lucabelluccini/accelerometermouse/README.md

# accelerometermouse
Automatically exported from code.google.com/p/accelerometermouse

Accelerometer-based USB Mouse, powered by
  * Microchip PIC18F14K50 microcontroller
  * MEMSIC MXC62020J accelerometer

[Video](http://www.youtube.com/watch?v=kykNB3RcyWo)
