lucabelluccini/accelerometermouse/Files/electrical-diagram.png

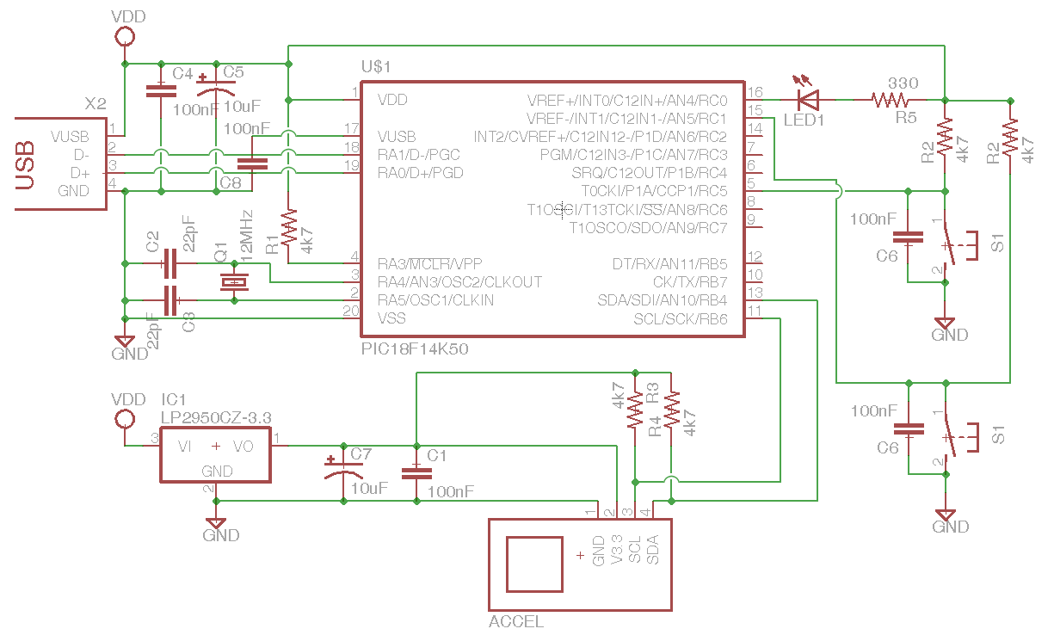
Files/electrical-diagram.png
