lucabelluccini/accelerometermouse/Files/assembly-diagram-lacks of a switch.pdf

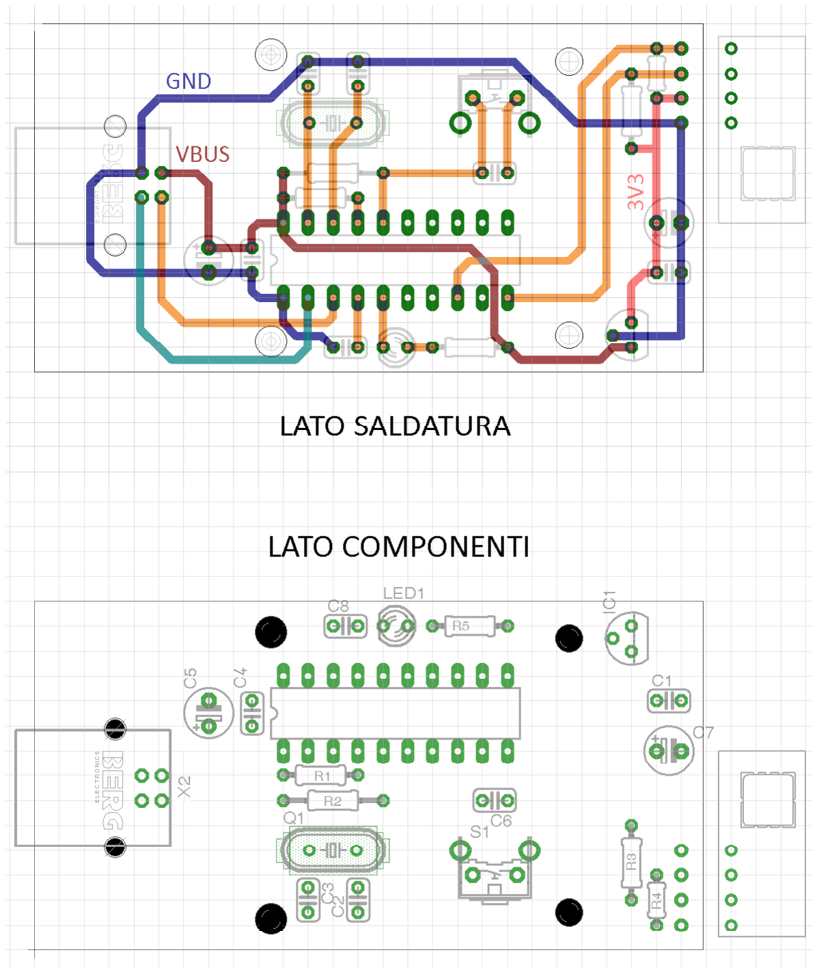
[picture p2: page 1]
