lucabelluccini/accelerometermouse/TopoTester/Resources/231_topo_trappola_1.jpg

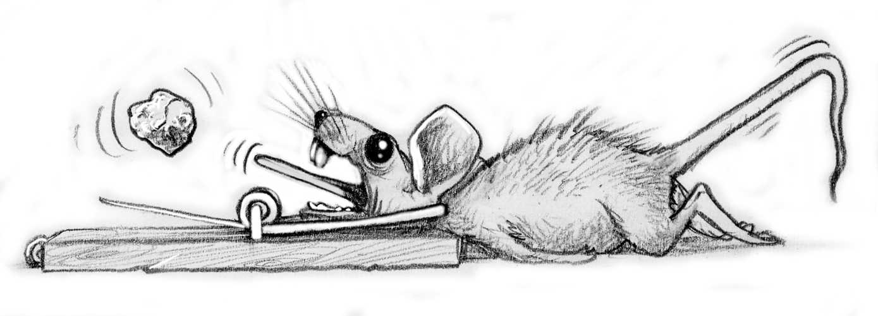
TopoTester/Resources/231_topo_trappola_1.jpg
