lucabelluccini/accelerometermouse/TopoTester/Resources/direzioni.png

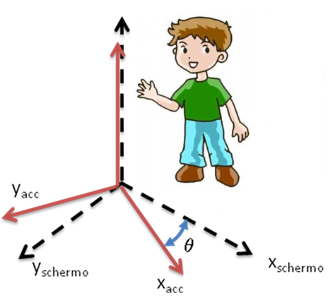
TopoTester/Resources/direzioni.png
