lucabelluccini/accelerometermouse/TopoTester/Resources/topo.gif

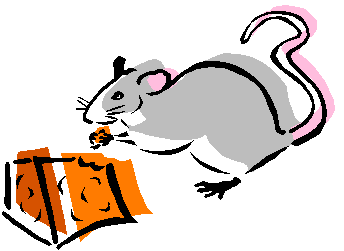
TopoTester/Resources/topo.gif
