lucabelluccini/accelerometermouse/TopoTester/Resources/topo.png

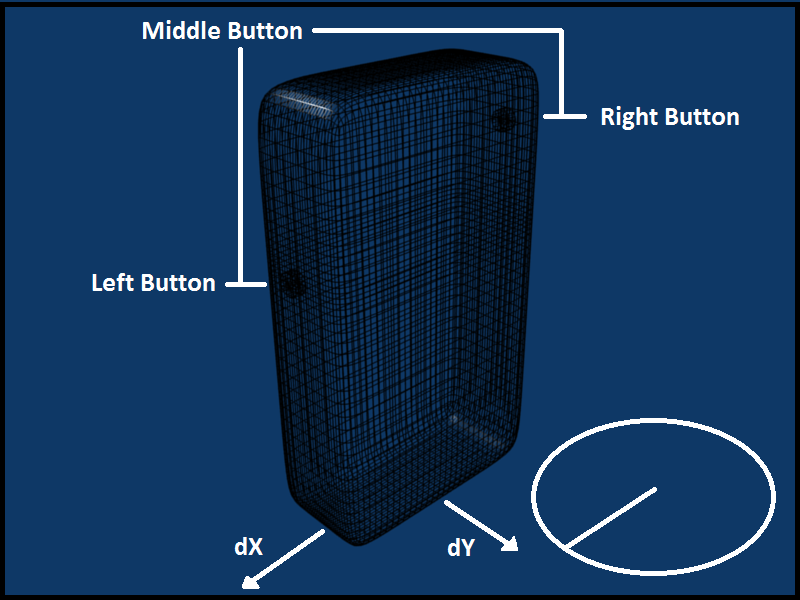
TopoTester/Resources/topo.png
